Waranika/Fan-project-control-table/Arduino/pwmtest/Test_pin3_0toMax/Test_pin3_0toMax.ino

#include <Wire.h>
#include <Adafruit_PWMServoDriver.h>

// called this way, it uses the default address 0x40
Adafruit_PWMServoDriver pwm = Adafruit_PWMServoDriver();
// you can also call it with a different address you want
//Adafruit_PWMServoDriver pwm = Adafruit_PWMServoDriver(0x41);
// you can also call it with a different address and I2C interface
//Adafruit_PWMServoDriver pwm = Adafruit_PWMServoDriver(0x40, Wire);

// Depending on your servo make, the pulse width min and max may vary, you 
// want these to be as small/large as possible without hitting the hard stop
// for max range. You'll have to tweak them as necessary to match the servos you
// have!
#define SERVOMIN  0 // This is the 'minimum' pulse length count (out of 4096)
#define SERVOMAX  1600 // This is the 'maximum' pulse length count (out of 4096)
#define USMIN  600 // This is the rounded 'minimum' microsecond length based on the minimum pulse of 150
#define USMAX  2400 // This is the rounded 'maximum' microsecond length based on the maximum pulse of 600


// my pwm pin
uint8_t servonum = 3;

void setup() {
  Serial.begin(9600);
  Serial.println("Servo control test!");

  pwm.begin();

  pwm.setOscillatorFrequency(27000000);
  pwm.setPWMFreq(0);  // Analog servos run at ~50 Hz updates

  delay(10);
}

void loop() {
  // Drive each servo one at a time using setPWM()

  for (uint16_t pulselen = SERVOMIN; pulselen < SERVOMAX; pulselen++) {
    pwm.setPWM(servonum, 0, pulselen);
  }
  

  
}
