Waranika/Fan-project-control-table/(commit log)

2022-10-12 added basic fan test
2022-10-15 Added fan calibration code
2022-12-26 refactor, PID, dynamic calibration
2023-01-03 organized communication and debug utils, refactor, added missing documentation
    [common_config.h, control.cpp, control.h, main.cpp]
